olivrrrr/ZenTimer/docs/hardware-demo.md

# ZenTimer: 20-Minuten-Präsentations-Build

Branch `feature/timer-core`. Der erste integrierte Build wurde auf das Gerät geladen und
auf der Hardware getestet. LCD, CST816S-Touch und kontinuierliche Drag-Koordinaten
sind bestätigt. **Die hier dokumentierte Folgeversion mit
Roboto-Ziffern, breitem Kreis, Minus/Plus und Abschlussblinken ist kompiliert, lokal getestet und am
06.10.2026 auf `/dev/cu.usbmodem2401` geflasht. Der Uploader bestätigte
„Device programmed.“ Auch die aktuelle Version mit Roboto, breiterem Ring und 8-MHz-SPI wurde
erfolgreich auf diesen Port geflasht. Der serielle Monitor bestätigte
„LCD: Hardware-SPI 8 MHz“ und den konfigurierten Touchcontroller. Die vollständige Funktionsabnahme ist noch nicht protokolliert.** Der vorhandene `Displaytest/Displaytest.ino`
bleibt unverändert; der Mac-Simulator verwendet weiterhin denselben Timerkern.

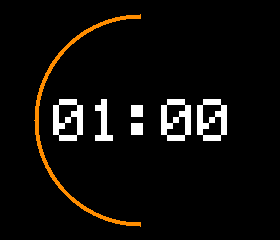
[picture p2: docs/images/hardware-ui-preview.png]
Ältere gerenderte Vorschau des Kreislayouts nach einer Minute


*Ältere Vorschau aus dem C++-Renderingtest, kein Hardwarefoto. Die aktuelle
Version verwendet Roboto-Ziffern und einen breiteren geglätteten Bogen; in Ready
kommen graue Minus-/Plus-Symbole hinzu. Für diese Änderung wurden
keine lokalen Tests oder neuen Vorschau-Renderings ausgeführt.*

Die Geräte-Startdauer steht in `ZenTimer.ino`: `timer.setDuration(1200)`
setzt 20 Minuten. Der TimerCore- und Simulator-Standard bleibt bei 10 Minuten.

## Bedienung und Anzeige

Nach dem ersten Bildaufbau steht `20:00` mittig auf einem dezenten Steinmotiv. In Ready sind
links ein dezentes graues Minus und rechts ein Plus sichtbar. Außerhalb von
Ready verschwinden beide. Zustandslabels und Menüs bleiben ausgeblendet.

| Zustand | Bedienung |
| --- | --- |
| Ready | Links: −1 Minute; rechts: +1 Minute; Mitte: kurzer Tap zum Starten |
| Running | Einzel-Tap pausiert; Doppeltipp bricht ab |
| Paused | Einzel-Tap setzt fort; Doppeltipp bricht ab |
| Finished | Kurzer Tap setzt zurück auf Ready |

Die Dauer bleibt allein im TimerCore gespeichert. Grenzen werden geklemmt,
nicht umgebrochen. Die bisherigen Serial-Befehle bleiben erhalten; sie können
weiterhin andere Sekundenwerte setzen. Minus/Plus addiert/subtrahiert dann
60 Sekunden und klemmt das Ergebnis auf 60–3600 Sekunden.

Der **orangefarbene Kreis ersetzt den linearen Balken vollständig**. Sein
Bogen startet unten bei 6 Uhr und wächst im Uhrzeigersinn: unten → links →
oben → rechts → unten. Bei 50 % ist die linke Hälfte sichtbar, am Ende der
Kreis geschlossen. Er zeigt verstrichene Meditationszeit; Pause zählt nicht
mit. Der Bogen wird in 2°-Schritten aktualisiert, mit weichen Kanten und runden
Bogenenden. Die Zeit verwendet geglättete Roboto-Ziffern mit gleich breiten Ziffernfeldern. Die weißen Ziffern bleiben
mit Abstand innerhalb des Kreises. Auf dem aktuellen logischen 280 × 240
Bild beträgt der Radius der Strichmitte 104 Pixel, die Strichbreite ungefähr
6 Pixel mit geglätteten Randpixeln, also etwa 3 Pixel breiter als zuvor.
Ein vollständiger Ring in verblasstem Orange (18 % Deckkraft) liegt dauerhaft
unter dem hellen Fortschrittsbogen; er ist auch in Ready sichtbar. Der Orangeton ist etwas wärmer.
Dies ist ein geometrischer Zwischenstand, kein nachgezeichneter Ensō.

`TimerCore::remainingSeconds()` rundet unverändert auf: Bei 120 Sekunden bleibt
anfangs `02:00` für die erste Sekunde stehen. Die Zeitmessung läuft unabhängig
von der Displayübertragung. USB Serial bei 115200 Baud bleibt aktiv, auch bei
fehlendem Touchcontroller. Beim Verbinden wird dessen Konfigurationsstatus
angezeigt; erkannte Eingabeaktionen geben einmal ihre logische Position aus.

**Abschluss:** Erst nachdem `00:00` und der vollständige Kreis übertragen
wurden, blinkt nur die Hintergrundbeleuchtung D6: aus/an, aus/an, aus/an;
je Phase 300 ms, anschließend dauerhaft an. Inhalt und Farbe bleiben während
aller Phasen gleich. Wiederholte Updates in Finished starten das Blinken nicht
neu. Ein Tap zurück auf Ready beendet eine laufende Blinkfolge und schaltet
wieder auf dauerhaft an. `CompletionBlink` verwendet unsigned Zeitdifferenzen,
kein `delay()` und keine TimerCore-Änderung.

## Statisches Steinmotiv

Stand 07.10.2026: Arduino-Build erfolgreich (211152 Byte Flash / 142308 Byte
RAM) und auf `/dev/cu.usbmodem2401` geflasht, bestätigt durch „Device programmed.“
Lokale Tests wurden für diese Änderung nicht ausgeführt.

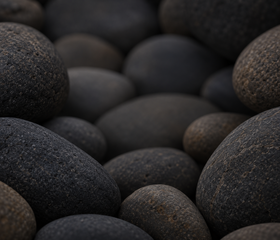
[picture p3: assets/backgrounds/stones-lcd.png]
Dunkle Flusssteine als statischer Timerhintergrund


Das Steinmotiv ist KI-generiert. Das Ausgangsbild liegt unter
`assets/backgrounds/stones-source.png`, die Displayfassung unter
`assets/backgrounds/stones-lcd.png`. Es wird als 280 × 240 RGB565-Bild im Flash
gespeichert (134400 Byte),
ohne zusätzlichen RAM-Framebuffer. Der Renderer dimmt es auf 60 % und legt
Ziffern, Symbole und Kreis mit Deckkraft darüber. Unter geänderten Inhalten
wird das statische Bild wiederhergestellt, keine schwarzen Löschrechtecke.
Der Hintergrundring ist wieder auf die vorherigen 18 % Deckkraft zurückgestellt.

Zum erneuten Konvertieren mit Python und Pillow:

```sh
python3 tools/generate_stone_background.py
```

## Doppeltipp zum Abbrechen

Stand 07.10.2026: Doppeltipp und der orangefarbene Hintergrundring
sind lokal implementiert und erfolgreich kompiliert (76160 Byte Flash /
142308 Byte RAM). Der Upload dieses Zwischenstands wurde zunächst nicht freigegeben; der
nachfolgende 20-Minuten-Build wurde anschließend erfolgreich geflasht.
Lokale Tests wurden weiterhin nicht ausgeführt.

In Running und Paused werden zwei kurze Taps innerhalb von 400 ms und mit
höchstens 60 Pixel Abstand als Doppeltipp erkannt. Er bricht die Sitzung ab
und kehrt mit derselben eingestellten Dauer auf Ready zurück. Der erste Tap
pausiert nicht vorab: Ein Einzel-Tap wird erst nach dem 400-ms-Fenster ausgelöst.
In Ready startet ein Tap weiterhin unmittelbar; dort gibt es keinen
Doppeltipp-Abbruch. Plus/Minus reagieren weiterhin auf den ersten Kontakt.
Ein Zustandswechsel, beispielsweise durch Serial, verwirft wartende Taps.
Die Erkennung liegt in `TapSequence`, nicht im TimerCore.

## Aufbau

- `TimerCore` und `TimeSource` bleiben unverändert und hardwareunabhängig.
- `TimerActions.h` kapselt die gemeinsame Aktivierungsaktion für Touch und
  einen späteren Sensor.
- `TimerDisplay` rendert Zeit und Fortschrittskreis in einen nativen
  RGB565-Framebuffer (134400 Byte) und verwendet nur `DisplayDriver`.
- `St7789SoftwareSpi` behält seinen bisherigen Dateinamen, unterstützt jetzt
  aber Hardware-SPI mit 8 MHz und einen Software-SPI-Fallback. Resetwartezeiten
  und Minimalinitialisierung bleiben aus dem bestätigten `Displaytest` erhalten.
- `TouchInput` liest CST816S-Kontakte über Wire und übergibt sie an
  `TouchGesture`. Diese gibt genau eine semantische Aktion beim Loslassen aus.
  Die ISR setzt nur ein Flag; I²C findet in der Hauptschleife statt.

Die LCD-Initialisierung bleibt bei `01`, `11`, `3A=55`, `36=00`, `13`, `21`,
`29`. Fenster verwenden `2A`, `2B` mit Y-Offset +20 und `2C`. Keine zusätzlichen
Prospector-Register und keine Adafruit-ST7789-Bibliothek. Geändert wurde der
Transport auf SPIM3/EasyDMA mit 8 MHz, Modus 0 und MSB zuerst. MISO und
automatisches CS sind explizit deaktiviert; D9 bleibt manuell gesteuertes CS.
RGB565 wird in RAM-Blöcken ausdrücklich als High-Byte/Low-Byte serialisiert.
EasyDMA-Aufrufe sind synchron; spätestens nach 96 Pixeln kehrt die Hauptschleife
zur Touch- und Timerverarbeitung zurück.

Nach dem vollständigen Erstaufbau werden nur geänderte Zeit- und Bogenbereiche
als zusammenhängende Rechtecke übertragen. Der vorhandene Framebuffer bleibt
für die zentrale Drehung und konsistente Regioneninhalte erhalten. Die Ursache
der bisher beobachteten Artefakte ist weiterhin ungeklärt; weder lokale
Schreibzugriffe noch ein anderer Treiber gelten dadurch als bewiesen gut oder
schlecht. Es wurde dafür kein weiterer Buffer für die Artefakte eingeführt. Der schnellere Transport ist ein separater,
bewusst vorgenommener Schritt; er beweist keine Ursache der alten Artefakte.
Während einer Region bleibt CS LOW; pro Hauptschleife werden höchstens
96 Pixel gesendet. Zwischen diesen Paketen laufen Timer, Serial und Touch.
Der Framebuffer wird während der Übertragung nicht verändert. Neue sichtbare
Werte werden nach Abschluss übernommen; unter Last können Sekunden ausgelassen
werden. Die tatsächliche Übertragungsdauer muss auf der Hardware geprüft werden.
Identische Inhalte lösen keine erneute Übertragung aus.

## Orientierung und Touch

Die einzige Einstellung ist `BoardConfig::Rotation` in
`hardware/BoardConfig.h`. Vorgabe: `Clockwise`, logische Anzeige **280 × 240**.
Der Controller bleibt nativ **240 × 280** mit `MADCTL=0x00`.

Für diesen Modus bildet `ScreenGeometry` native Koordinaten auf
`screenX = 279 - rawY`, `screenY = rawX` ab; die inverse Transformation wird
für das Zeichnen verwendet. Das folgt aus der Beobachtung „native Oberkante
liegt physisch rechts“. Ob die gewünschte Geräteaufstellung genau so gemeint
ist, bleibt ein Hardwareprüfpunkt. Andere Vierteldrehungen werden zentral
unterstützt. Touch außerhalb der nativen Grenzen wird verworfen, nicht an den
Bildrand geklemmt. Es wird angenommen, dass CST-Rohkoordinaten zur nativen
LCD-Ausrichtung passen; das muss anhand der Ecken überprüft werden.

Bestätigte Pins: LCD DIN D10, CLK D8, CS D9, DC D7, RST D3, BL D6;
Touch SDA D4, SCL D5, **IRQ D0, RST D1**. Die Dokumentation und
Verbindungsskizze wurden gegenüber dem früheren Anschlussentwurf korrigiert.

Der Touchcontroller wird auf Kontakt-/Änderungs-IRQ eingestellt
(`IrqCtl 0xFA = 0x60`, EnTouch + EnChange). Aus Register 0x02 werden Fingerzahl
und Rohposition gelesen. Laufende Kontakte werden mit einem Mindestabstand von
15 ms abgefragt; der tatsächliche Abstand hängt von der Hauptschleife ab.
Die Transformation erfolgt ausschließlich über `ScreenGeometry`.
[Quelle: Waveshare CST816S-Registerbeschreibung](https://files.waveshare.com/wiki/common/CST816S_register_declaration.pdf).

In Ready belegen Minus und Plus jeweils den gesamten linken/rechten
64-Pixel-Streifen des logischen 280 × 240 Bilds. Die Symbole selbst sind
bewusst klein. Der 152-Pixel-Bereich dazwischen bleibt für den Start-Tap.
Die Seiten reagieren sofort auf den ersten gültigen Kontakt, ohne auf ein
Loslass-Signal zu warten. Der Kontakt wird anschließend verbraucht: kein
Autorepeat und kein zusätzlicher Start-Tap beim Loslassen.

In der Mitte und außerhalb von Ready wird ein Tap beim Loslassen erkannt:

- Bewegte Kontakte werden nicht als Tap behandelt; Wischgesten werden von
  der aktuellen Oberfläche nicht zur Dauersteuerung verwendet.
- Höchstens 500 ms und maximal 14 Pixel Bewegung: Tap.
- Halten, seitliches Gleiten oder Bewegung weg und zurück: keine Tap-Aktion.
- Fehlerhafte I²C-Lesevorgänge oder ungültige Kontaktkoordinaten verwerfen den
  Kontakt; fehlende Daten werden nicht als Loslassen interpretiert.
- Nach einem Kontakt werden neue Kontakte innerhalb von 50 ms verworfen,
  um Kontaktprellen zu unterdrücken. Controller-GestureID-Berichte werden nicht
  zusätzlich in Aktionen umgesetzt; damit gibt es keinen zweiten Start-Tap nach
  dem Drücken von Minus oder Plus.

Am Gerät ist insbesondere zu bestätigen, dass Kontakt-IRQ und Fingerzahl 0
beim Loslassen mit der neuen IRQ-Einstellung zuverlässig geliefert werden.

## Kompilieren und unabhängiger Farbtest

Keine neuen Firmwarebibliotheken erforderlich: Seeeduino:nrf52 1.1.13 liefert
Arduino, TinyUSB, Wire und nrfx/SPIM. Die Ziffernmasken liegen im Flash. Wie bisher muss `~/.local/bin` für Python im PATH sein.

```sh
PATH="$HOME/.local/bin:$PATH" arduino-cli compile \
  --fqbn Seeeduino:nrf52:xiaonRF52840Sense --build-path build/arduino .
```

VS Code: **ZenTimer: Build**. Der unabhängige Farbmodus verwendet denselben
Treiber und wiederholt Rot → Grün → Blau → Weiß → Schwarz. Jede Farbe bleibt
nach vollständiger Übertragung mindestens eine Sekunde sichtbar. Touch steuert
in diesem Modus keine Sitzung; es werden keine UI-Regionen gezeichnet.

```sh
PATH="$HOME/.local/bin:$PATH" arduino-cli compile \
  --fqbn Seeeduino:nrf52:xiaonRF52840Sense --build-path build/color-test \
  --build-property compiler.cpp.extra_flags=-DZENTIMER_COLOR_TEST=1 .
```

VS Code: **ZenTimer: LCD Farbtest Build**. Zur Timer-UI zurückkehren, indem
ohne diesen Build-Schalter gebaut wird. Beide Tasks kompilieren nur.
Vor einem späteren, ausdrücklich ausgelösten Upload den USB-Port mit
`arduino-cli board list` neu prüfen und den Monitor schließen.

## Lokale Prüfung und Abnahme am Gerät

```sh
c++ -std=c++11 -Wall -Wextra -pedantic tests/timer_core_test.cpp \
  -o /tmp/zentimer-core-test && /tmp/zentimer-core-test
c++ -std=c++17 -Wall -Wextra -pedantic tests/simulator_clock_test.cpp \
  -o /tmp/zentimer-clock-test && /tmp/zentimer-clock-test
c++ -std=c++11 -Wall -Wextra -pedantic tests/timer_display_test.cpp \
  TimerDisplay.cpp -o /tmp/zentimer-display-test && /tmp/zentimer-display-test
c++ -std=c++11 -Wall -Wextra -pedantic tests/interaction_test.cpp \
  -o /tmp/zentimer-interaction-test && /tmp/zentimer-interaction-test
```

Die Tests prüfen die Drehungen, übertragenen Pixel, fehlende redundante
Updates, Rundung, Kreisstart/-richtung/-abschluss, zentrale Zeit und die
Rückkehr vom Farbtest. Eingabetests prüfen Swipe/Tap-Trennung, Grenzen,
Zustandssperren, ungültige Kontakte und Zeitüberlauf. Der Anzeigetest prüft
zusätzlich das vollständige Abschlussbild vor Blinkbeginn, genau drei
OFF/ON-Paare, unveränderte Pixel während des Blinkens, kein erneutes Starten
in Finished und Abbruch der Blinkfolge beim Reset.

Die bisherigen Testergebnisse beziehen sich auf frühere UI-Stände. Für die
aktuelle Änderung werden keine lokalen Unit-Tests
oder Renderingtests ausgeführt; geprüft wird die Arduino-Kompilierung für den
normalen Build und die Software-SPI-Rückfalloption. Beide bauen erfolgreich:
8-MHz-Build 75896 Byte Flash / 142296 Byte RAM; Software-SPI-Build 75160 Byte
Flash / 142296 Byte RAM. Neue Hardwarefunktionen
werden dadurch nicht als am Gerät abgenommen behauptet.

## Geschwindigkeit und Rückfalloption

Hardware-SPI nutzt zunächst **8 MHz**, nicht 16/32 MHz. Ein Vollbild enthält
134400 Byte; die reine Übertragung benötigt theoretisch rund 134 ms statt
mindestens 2,15 s mit dem bisherigen Software-SPI. Renderzeit, Paket- und
Schleifenaufwand kommen hinzu. Es werden keine gemessenen FPS behauptet.
Die LCD-Initialisierung und der Y-Offset bleiben unverändert.
[SPIM/EasyDMA-Dokumentation von Nordic](https://docs.nordicsemi.com/bundle/ps_nrf52840/page/spim.html).

Bei fehlgeschlagener SPIM-Initialisierung wird Software-SPI verwendet. Im
Serial-Monitor steht beim Verbinden, welcher Transport tatsächlich aktiv ist.
Ein ausdrücklich erzwungener Fallback-Build behält die neue Oberfläche bei:

```sh
PATH="$HOME/.local/bin:$PATH" arduino-cli compile \
  --fqbn Seeeduino:nrf52:xiaonRF52840Sense --build-path build/software-spi \
  --build-property compiler.cpp.extra_flags=-DZENTIMER_SOFTWARE_SPI=1 .
```

VS Code: **ZenTimer: Software-SPI Fallback Build**. Der Build-Pfad ist vom
normalen Build getrennt; ein Fallback-Upload muss dessen Artefakte verwenden.
Der separate `Displaytest` bleibt zusätzlich unverändert als ursprüngliche
Hardware-Referenz erhalten.

## Schriftasset

Roboto aus [Google Fonts](https://github.com/google/fonts/tree/main/ofl/roboto),
Gewicht 350, wird mit vierfacher Auflösung gerastert und auf 4-Bit-Deckkraft
reduziert. Die Firmware benötigt nur Ziffern und Doppelpunkt, ungefähr 11 KB
Maskendaten im Flash. Sie berechnet keine geometrischen Ziffernstriche mehr.
Schriftquelle und SIL-OFL-1.1-Lizenz liegen in `assets/fonts/`. Zum erneuten
Erzeugen wird Python mit Pillow benötigt:

```sh
python3 tools/generate_timer_font.py
```

Das Skript aktualisiert `hardware/TimerFont.h`; es ist kein Unit-Test und
wird zum normalen Firmware-Build nicht benötigt.

Für die Abnahme der geflashten Version am Gerät prüfen:

1. Schrift und Kreis stehen richtig; sie überlappen nicht. Kein Balken mehr.
2. In Ready links/rechts drücken: ±1 Minute, Minimum 1, Maximum 60 ohne Wrap.
   Auch seitliche Berührungen deutlich ober-/unterhalb der Symbole ausprobieren.
3. Halten auf Minus/Plus ändert die Dauer einmal. Loslassen startet nicht;
   ein separater kurzer Tap in der Mitte startet genau einmal.
4. Außerhalb von Ready sind Minus/Plus verborgen und ändern die Dauer nicht.
5. Pause hält Zeit und Kreis; Fortsetzen zählt korrekt weiter.
6. `00:00` mit geschlossenem Kreis; danach exakt drei ruhige Lichtblinks,
   ohne Löschen, neue Grafik oder erneutes Blinken beim Warten.
7. Doppeltipp während Running und Paused bricht ab, ohne danach neu zu starten.
   Einzel-Taps pausieren/setzen nach ungefähr 400 ms fort.
   In Finished setzt ein Tap auf die eingestellte Dauer zurück. Auch Reset während eines
   OFF-Intervalls schaltet das Licht wieder an.
8. Serial funktioniert während Displaytransaktionen. Für einen schnellen
   Abschluss aus Ready `duration 5`, dann `start` verwenden.
9. Unabhängigen Farbtest bei Artefakten vergleichen; nicht gleichzeitig
   Treiber, Transport und Initialisierung wechseln.

Ensō, Gong, Proximity, Energiesparen, Synchronisierung und ein Hardwarewechsel
bleiben spätere Schritte. D2 ist für einen möglichen Sensor-Interrupt frei;
Audio benötigt anschließend eine bewusste Planung des knappen Pinbudgets.

## Gerätemenüs und nichtflüchtige Speicherung

Der neue Build ergänzt Profile, Anzeigeoptionen und **Gespeicherte Sitzungen**.
Öffnen: in Bereitschaft die Mitte etwa eine Sekunde halten. Das Menü ist nur
in Bereitschaft verfügbar; Tap und Doppeltipp im laufenden Timer bleiben erhalten.
Die zuletzt eingestellte Dauer ersetzt beim nächsten Start den Demo-Standard,
wenn ein gültiger Einstellungsdatensatz vorhanden ist.

Der [Speicher- und Exportleitfaden](sessions.md) beschreibt QSPI-Journal,
Stromverlustverhalten, fehlendes Kalenderdatum, USB-Befehle und Mac-Ablage.
Diese Ergänzung ist kompiliert und softwareseitig geprüft; die Abnahme an der
Hardware und der Import einer Bridge-Datei in Timefully stehen noch aus.
Bluetooth und Audio sind nicht Bestandteil der Ergänzung.
