olivrrrr/ZenTimer/(commit log)

2026-10-06 Add modular timer firmware and native macOS simulator
2026-10-06 Document Waveshare touch LCD wiring plan
2026-10-06 Add illustrated display wiring instructions
2026-10-06 Integrate LCD timer UI with swipe controls and completion blink
2026-10-06 Add Ready duration buttons and smooth timer graphics
2026-10-06 Speed up LCD transport and add Roboto timer font with dim circle track
2026-10-06 Add double-tap session cancellation and brighten circle track
2026-10-06 Set hardware timer default to 20 minutes
2026-10-06 Restore subtle circle track and add static stone background
2026-10-06 Add persistent session journal, device menus and USB Open Sit export
